kdp1965/tt07-um-lisa-ttlc/lisa-test/README.md

# LISA Commander — browser-based programmer, console and debugger

A Web Serial app for testing the **LISA** microcontroller (`tt_um_lisa`, TT06 and
TT07) on a Tiny Tapeout demo board, in the spirit of the
[TinyQV programmer](https://program.tinyqv.com/): connect the board, click
**Program**, and talk to the running program through a UART console.

Live: **https://kdp1965.github.io/tt07-um-lisa-ttlc/** (Chrome or Edge).

Everything lives in this directory:

| | |
|---|---|
| `web/index.html` | the app — a single page, no build step, no external scripts |
| `web/assets.js` | generated: the board-side Python and the demo firmware, embedded |
| `web/build_assets.py` | regenerates `assets.js` after editing `board/` or `firmware/` |
| `board/uartPass.py` | USB ↔ LISA-debug-UART pass-through, installed on the board's filesystem |
| `board/lisa_flash.py` | project select/reset and direct SPI-flash programming; sent to the board's RAM on connect |
| `board/ttlc_sim.py` | PIO + DMA emulation of the TTLC's 74HC595/74HC166 I/O chains; sent to RAM on connect |
| `firmware/bringup_tt07`, `bringup_tt06` | the bring-up demo (prints a banner on `?`), one hex opcode per line |
| `firmware/sdcc_hello.ihx`, `firmware/sdcc_hello/` | the same demo in C, built with the SDCC LISA port (`sdcc -mlisa`, in `lisa-tools/sdcc-lisa`); `s` prints the count and sum with a working `%u` |
| `firmware/lisa_monitor_small.ihx`, `firmware/lisa_monitor.ihx` | the LISA monitor (`lisa-tools/lisa_monitor`, `make commander` copies both here): `help`, RAM dump and write, the stack, `free` with the stack's high-water mark, `calc` with bf16 on the FPU, timed. The small one runs in the chip's 128-byte RAM and needs nothing on the board; the other is built with `--tt07-cache` and sets float32 (the software library) beside the bf16 - the app sets the data cache up on the RP2040's SPI RAM (the "Data cache" box, ticked for it) before the run, offering to flash the RP2040's MicroPython first if it lacks the emulation (`firmware/rp2040/`) |
| `firmware/ttlc/` | TTLC programs with their `.hex` from `mc14500_as.py`: `ttlc_loopback.asm` (inputs → outputs) and `elevator6x2.asm` (6 floors, 2 cars; generated by `gen_elevator6x2.py`, I/O map in `elevator6x2.h`) |
| `firmware/ttlc_tick/` | a LISA assembly program that could clock the TTLC from timer 1 through PORT E (TTLC addresses 128–135); not built or tested yet |
| `firmware/rp2040/` | Ken's MicroPython build for the RP2040 with the SPI RAM emulation (`rp2.enable_sim_spi_ram`, from the `lisa_spi_ram` branch of his micropython fork; provenance and rebuild notes in its README), embedded too. When an image for the data cache is chosen on a board whose MicroPython lacks the emulation, the app asks first, then restarts the RP2040 into its bootloader, has you choose the `RPI-RP2` drive, writes the `.uf2` there and reconnects once the board is back (the TT SDK and the files on its flash survive). Writing to the drive needs Chrome/Edge's directory picker: a page cannot write to a disk on its own, so the drive is chosen the first time, then remembered (one click to allow it again, none once the browser persists the permission); otherwise download the file and copy it by hand. Before it flashes anything the app backs the RP2040 up: the whole flash (MicroPython and its files, read through the XIP window) as a `.uf2` like the stock image, downloaded and kept in the browser (IndexedDB, per board); the Board panel's "Back up RP2040" does that on its own and "Restore…" flashes that backup or any `.uf2` |
| `test/` | hardware regression test of the app's protocol code (Node + a small serial bridge) |

## Using it

You need Chrome or Edge, a TT06/TT07 demo board running the TT MicroPython SDK
(2.0.x), and the QSPI Pmod on the bidirectional Pmod connector — LISA runs from
the SPI flash on `uio[0..3]` (CS, MOSI, MISO, SCK). The PSRAMs and the Pmod's
`SD2/SD3` lines are not used.

Open the page (GitHub Pages, `python3 -m http.server` in `web/`, or simply
double-click `index.html` — Chrome treats local files as a secure context), close
any `mpremote`/terminal session on the port, then:

1. **Connect board** and pick the board's serial port. The app enters the raw
   REPL, checks the SDK and shuttle, installs or updates `/uartPass.py` on the
   board if needed, probes the flash (JEDEC ID), enables `tt_um_lisa`, pulses its
   reset, starts the pass-through, locks the debug UART's autobaud, checks the
   debugger version (`lisav1.2`) and writes the setup registers. About 3 s.
2. **Program** the selected image. Two methods, chosen with the radio buttons:
   * **Direct** — the RP2040 drives the flash's SPI pins itself (SoftSPI, ~2 Mbit/s),
     while LISA is deselected so the ASIC is not driving those pins. The flash is first
     forced back into plain SPI mode (TinyQV leaves it in QSPI continuous-read mode),
     then sectors are erased, pages programmed and read back. Afterwards LISA is
     re-selected, reset and set up again. A few hundred ms for the demo, plus ~2 s
     for the re-initialization.
   * **Via LISA** — the debug UART: halt, `w21 0006`/`w21 01d8` (write-enable, 64 KB
     block erase), then one `w20xxxx` write and `r22` status poll per opcode. The
     flash sees exactly what LISA's own QSPI controller sends. Measured at
     3.8 ms per opcode in a browser-equivalent setup: ~3 s for the 799-opcode demo,
     a couple of minutes for a full 32K-opcode image.
3. With **Run after programming** ticked, the core starts at PC 0 and gets the UART
   (`l`). Click into the console and press `?` for the banner (`s` prints a
   counter line, unformatted: the firmware's `printf` does not do `%d` yet).

The **LISA core** panel has Run / Halt / Resume / Step / Reset, the registers
(PC, SP, RA, IX, ACC, flags, cond, and the opcode at PC read from the flash) and
a dump of the 128-byte data RAM with SP marked. **Verify** reads the flash back
(over SPI or through LISA, per the selected method) and compares it with the
image. Step and the RAM dump work around two properties of the TT07 silicon,
see below.

### TTLC (the MC14500B logic controller)

The TTLC runs its own program from the flash (16-bit words at `{reg 0x1f, 8'h0} |
pc << 1`; `inst[3:0]` opcode, `inst[15:4]` address — what `mc14500_as.py`
emits) and talks to the outside world through 48 outputs and 48 inputs on three
74HC595 / 74HC166 chains: three data lines each way, a shift clock and a latch,
all on `uo_out` / `ui_in` once debug register 0x1b routes them there
(`uo_out[0..2]` data out, `[5]` latch, `[6]` shift clock, `[3]` ttlc_reset;
`ui_in[6:4]` data in). On the demo board those are RP2040 pins, so
`ttlc_sim.py` plays the chains with two PIO state machines and two DMA ring
buffers: the outputs are always available in RAM, the inputs are replayed on
every scan, and the CPU is never involved. It is driven in-band through the
pass-through (`uartPass.py` 2.1's NUL-framed sideband), so the LISA console
keeps working meanwhile.

The panel programs a TTLC image at its own flash base (default 0x010000, 64 KB
aligned, with either programming method), sets registers 0x1f / 0x1b / 0x1c
(shift-clock divider; `clk/32` by default), invalidates the TTLC instruction
cache, and leaves the TTLC halted at PC 0 (the chip is reset: the TTLC PC is
not writable). **Run / Halt / Restart**, **Step**, **Scan** (run until the next
`nopo`, i.e. one PLC cycle — the reliable stepping unit, see below), a code
window with a MC14500B disassembly, 48 output LEDs refreshed live and 48 input
toggles. I/O addresses: 0–47 outputs, 48–95 inputs, 96–127 storage (96–103 are
also the port to LISA, 104 the LISA interrupt), 128–135 from LISA, 136 = RR.

**Timing.** The TTLC has no timer and only 32 storage bits, so a PLC program
takes its clock from the I/O rack: the emulator toggles **input 47** every N ms
(the field next to the input grid, default 500 ms, 0 = off) and programs
edge-detect it.

**The elevator controller** (`elevator6x2.asm`, 531 instructions) runs two
collective-control cars over six floors. Inputs are momentary buttons, the same-
numbered outputs are sticky request indicators: inputs 0–9 are the hall calls
(F0 up, F1 up/down, F2 up/down, F3 up/down, F4 up/down, F5 down), 10–15 car 1's
cabin buttons for floors 0–5, 16–21 car 2's. Outputs 32–37 / 38–43 show where
each car is, 22/23 its door, 24–27 its direction. On every tick a car keeps its
door open (two ticks), closes it, opens it because a request is at its floor
(clearing that floor's indicators), or moves one floor toward the nearest
pending request, continuing in its direction while something is ahead. A new
hall call is dispatched to one car: the car already at that floor, else an idle
car (the one within two floors when both are idle), else car 1; a car stopping
at a floor clears every call there. When this program is selected, a picture of the
building appears in the right column (floors numbered 1–6 there): six floors, both shafts with the cars
gliding between floors (doors open on dwell, direction lamps), hall-call
buttons per floor and a cabin panel per car — all momentary buttons, lit from
the TTLC's indicator outputs. Press a hall call, watch both cars go; the first
one to arrive clears it. `gen_elevator6x2.py` emits the
`.asm` (the two cars run identical logic on different addresses, and the
MC14500B has no indirect addressing); `mc14500_as.py` now accepts the
hardware's 12-bit addresses and comments inside `enum` blocks. **Show source**
in the TTLC panel opens the selected program's assembly and headers.

### The UART console

The console is the pass-through to LISA's debug UART, so it is either talking to
the **debugger** (type `v`, `r02⏎`, `w020000⏎` … yourself) or, after `l`, to the
**LISA program**. The pill above the console shows who owns it. Run/Resume hand
the UART to the program; Halt and the other debugger actions take it back with
`+++` (300 ms guard either side) and hand it back afterwards when the program is
still running. Enter sends CR; Ctrl-C is never sent (it would stop the
pass-through on the RP2040); the bring-up firmware drops characters that arrive
back to back, so paste sparingly.

### TT07 silicon notes (what the app does about them)

Found by reading `lisa_dbg.v` / `lisa_core.v` / `tt_um_lisa.v` and confirmed on a
TT07 board:

* **Debugger data reads return `RAM[IX]`.** With the data cache off, the cache's
  `d_ready` is a constant 1, so the core answers a register-6 read (`dbg_ready =
  d_ready_r`) in the access's first clock — before the pipelined address register
  and the RAM have seen the debugger's address. What the debug controller latches
  is the RAM output for the *idle* address, which while halted is IX
  (`d_addr = stop ? ix : …`). The app therefore reads RAM by saving IX, writing
  the wanted address to IX (register 5), reading register 6, and restoring IX.
  Writes through registers 7/6 land correctly. (The same RTL with the cache
  *enabled* produces a proper multi-cycle ready, which is presumably why this
  looked fine on TT06 with an SRAM.)
* **The step bit does nothing.** Register 0 bit 2 pulses the core's `stop` low for
  a single clock (`cont` is cleared by `cont_q` on the next edge), and the TT07
  pipeline's pre-decode state checks `stop` again and returns to fetch, so no
  instruction executes and PC does not move. The app's Step instead decodes the
  opcode at PC, puts hardware breakpoints (registers 0x08–0x0d) on every address
  it can continue at — fall-through, branch target, RA for `ret`/`rc`/`rz`/`reti`,
  IX for `call ix`/`jmp ix` — resumes, waits for the halt, and clears them. `rets`
  (returns to IA, not readable) only gets the fall-through breakpoint.
* **A halt right after a store loses the store and overwrites RAM[IX].** A
  store's RAM write completes in the fetch cycle after its instruction; a
  hardware breakpoint on the next instruction raises `stop` in that very cycle,
  and while stopped the data address is IX and the data the debugger's last
  written byte (`lisa_core.v`: `d_addr = stop ? ix`, `d_o = dbg_di`). Measured:
  stopped right after `push a`, the slot kept a marker and RAM[IX] got 0x02, the
  data byte of the resume command. So the app never halts there: Step runs a
  store (`sta`/`stax`, `dcx`/`inx`, `swap`, `stxx`, `shl16`/`shr16`, `push`,
  `sra`, `div`/`rem`) on to the first instruction that is safe to halt at, and
  **Halt** samples PC while the program runs (register 2 reads live), plants
  breakpoints on the safe addresses of the loop it is in and lets it run into
  one — only if none is hit within a second does it fall back to the plain halt,
  with a warning. Programming and Run (restart from 0) still halt immediately.
  `test/hw_test.mjs hazard=<test_core.ihx>` checks it on the chip.
* **Reading register 0xf advances PC.** Any access to the "current opcode"
  register increments PC afterwards (`dbg_inc`: it is meant for loading code),
  which looks like "stepping" if you poll it. The app never touches 0xf; the
  opcode shown is read from the flash at `2 × PC`.
* **The TTLC input scan shifts 17 times** (`shift_reg_io.v`, state
  `SHIFT_IO`). The input shift is keyed on `!shift_clk && clk_count == 0` (the
  clock is low and about to toggle), which is right for the 16 real rising
  edges — but after the 16th falling edge the FSM waits one more clock period
  before going to `LATCH`, and in that period the toggle is suppressed by
  `last_clk` (`if (shift_clk | ~last_clk)`) while the shift condition is still
  true. The `shift_count` decrement next to it is gated with `!last_clk`; the
  input shift is not. The 16-bit register keeps the last 16 of the 17 samples:
  the chain's bit 15 is shifted out, bits 14…0 land in bits 15…1, and bit 0
  gets sample 17 — whatever the data line holds after the last clock: with a
  74HC165 chain that is the level shifted in behind bit 0 (its DS pin), so per
  16-bit segment `input_pins[i] = external bit i-1` for i = 1…15 and input 0
  reads a constant: every input one position too high, bits 15/31/47 lost.
  (The loopback showed it as `0001 → 0003`, `aaaa → 5554`, with the emulator
  holding bit 0 on the line.) RTL fix, e.g. for an FPGA build: add
  `&& !last_clk` to the input shift condition. Hardware fix for the TT07
  silicon: delay each data-in line by one shift clock — a D flip-flop (one
  74HC175 for the three lines) clocked by the shift clock between the 165
  chain and `ui_in[6:4]`, or simply wire the parallel inputs one stage closer
  to the serial output so a dummy bit is clocked out first. (The planned
  respin of the TTLC Pmod — the first one has its input and output connectors
  swapped — adds that 74HC175 as a 17th dummy stage on each of the three
  chains.) The emulator does
  the same in software (each bit presented one edge later); untick "play the
  TT07 silicon's 17-sample input scan" in the panel (before starting the TTLC)
  for RTL that has the fix.
* **The latch pulse cannot load a 74HC166.** `latch` is pulsed low before the
  scan with the shift clock held still; a 74HC166 loads its parallel inputs
  only on a clock edge while /PE is low, so on a real I/O Pmod use a 74HC165
  (asynchronous /PL) for the inputs. The output side (74HC595: data on rising
  edges, RCLK pulse after the 16 clocks) matches the RTL as is.
* **The TTLC step bit cannot work** (`ttlc_halt = !run | step` blocks the fetch
  whose `ttlc_i_ready` would clear `step`), and **its breakpoints stop one
  instruction late** when the next instruction is already in the single 4-word
  instruction cache: the compare runs a clock behind the fetch, and the
  instruction executed in that clock loses its PC effect if it is a
  `jmp`/`rtn`/`nopf`. Step therefore reports where the TTLC really stopped;
  Scan is exact because a `nopo` stalls the core until its I/O scan is done.
* **Interrupts cannot be used with compiled code.** The core samples an
  interrupt in the cycle that executes an `if`/`ifte`/`iftt` or the first
  word of an `ldx`, saving neither the predicate nor the pending literal:
  after `rets` the predicated instruction runs unconditionally, and the
  `ldx` gets the vector word with its literal executed as an opcode later.
  `lisa-tools/sdcc_test/test_irqhaz.ihx` counts both on the chip (2 and 1
  in 20 ms with a 1 ms timer). Handlers work, but only around hand-written
  code that avoids `if*` and `ldx` (`test_irq2.ihx`). Details and the RTL
  fixes in `lisa_isa.md` ("TT07 interrupt notes").
* **The ALU's carry/borrow flags are wrong in the corner cases** (found while
  running the SDCC test suite on the chip; `lisa_core.v` lines 643–652). The
  adder is `acc + acc_adder` with `acc_adder` an *8-bit* operand, and the
  carry-in is folded into that operand instead of being a real carry-in, so it
  is lost when the operand wraps:
  * `add M` adds without C — that one is by design (`adc` is the carry form);
    the ISA doc used to say `+C` and has been corrected;
  * `adc #k` adds `(k + C) & 0xff`: `adc #0xff` with C = 1 adds 0 and clears C;
  * `sub M` adds `~((M + C) & 0xff) + 1` (8 bits): `sub M` with M = 0, C = 0
    computes A + 0 and reports a borrow (C = 1), and `cmp M` with M = 0 reports
    a borrow for the same reason — `A - 0` always "borrows";
  * `cpi #k` sets C from a plain unsigned `k > A` comparator (correct) but never
    records the sign inversion, so `if slt`/`sgt` after `cpi` behave unsigned;
    the inversion (A[7] ^ M[7]) is captured only by `add`/`adc`/`sub`/`cmp` and
    cleared by every other flag writer (`ldi`, `ldc`, `shl`, `shr`, `inx`…).

  Results in A are always correct; only C (and the signed compare) can be wrong.
  `lisa-tools/lisa_sim` models the silicon exactly (the SDCC test suites pass
  identically on it and on the chip), and `sdcc -mlisa` works around it: multi-byte
  adds use `adc #0` for the carry-in before `add M`, subtractions are done as
  `adc #~k` with a `ldc 1` start and an `if nc` guard, and compares against
  memory first test the operand against 1 (`cpi #1`) so a zero operand takes
  the `ldc 0` path instead of `cmp`.

### Flash base (Advanced)

Default 0. A 64 KB-aligned base lets a LISA image coexist with other flash
contents (TinyQV firmware at 0, say). It is written to debug registers 0x10–0x12
and used by both programming methods and by Verify.

### Setup registers

Written on every (re-)initialization and read back (these were spread over
`loadFlash()`/`setFlashBase()`/`noCache()` in `lisa_pydb.py`, but a program loaded
directly needs them too):

| reg | value | |
|---|---|---|
| 0x11 / 0x12 / 0x10 | flash base | debug QSPI address MSB, LISA1 base, debug address LSB |
| 0x1c | 0x0000 | uio mux: plain SPI pins |
| 0x1b | 0x5455 | uo_out mux: LISA PortB |
| 0x17 | 0x0004 | CE0 is a single-SPI flash with 24-bit addresses |
| 0x1e | 0x08d3 | SPI mode 1, SCLK divider 3, 13 clocks between CE activations |
| 0x1d | 0x0007 | data cache off: the 128-byte RAM is the whole data space (no SRAM needed) |

### Firmware formats

* Intel HEX (what `sdcc -mlisa` writes; record addresses are byte addresses, 2 × PC),
* one 4-digit hex opcode per line (what `lisa_ld` and `lisa_pydb.py` use),
* `@addr` plus 2-digit hex bytes (the cocotb `firmware.hex` format; `@addr` is a byte address),
* a raw `.bin`.

Opcodes are stored little-endian at byte address `2 × PC`, which is what the
debugger's `w20` writes and what LISA's instruction fetch reads.

## Board side

`uartPass.py` is what makes the USB serial port behave as LISA's UART. It is
installed to `/uartPass.py` if missing or different from the copy in `board/`,
and is also what `lisa_pydb.py --init` imports. Note that it uses **UART0** on
GPIO12/13 (`ui_in[3]`/`uo_out[4]`): on the RP2040 those pins are UART0, and
`machine.UART(1, …)` on them raises `ValueError: bad TX pin`. It re-creates the
UART each time it starts (the SDK changes the RP2040 clocks when a project is
enabled), and passes bytes through unmodified in both directions.

`lisa_flash.py` is never stored on the board: the app sends it, stripped of
comments and docstrings, over the raw REPL (raw-paste mode) on every connect.
With the TT SDK loaded the RP2040 has only ~65 KB of fragmented heap, which is
why the transfers use 512-byte chunks and why the app soft-reboots the board
(through the friendly REPL, so `main.py` runs) if the SDK's `tt` object is gone
or a `MemoryError` shows up.

After editing `board/*` or `firmware/*`:

```sh
python3 web/build_assets.py
```

## Manual use (mpremote / lisa_pydb.py)

```sh
mpremote cp board/uartPass.py :/uartPass.py
mpremote repl
>>> tt.shuttle.tt_um_lisa.enable()
>>> import uartPass          # now the REPL *is* LISA's debug UART; Ctrl-C ends it
v                            # -> lisav1.2
```

`lisa_pydb.py --init --flash --run bringup_tt07` (in the `lisa-tools` repo) does the
same thing from the command line.

## Hardware test

`test/hw_test.mjs` runs the app's real protocol code (the `lisa-core` script block)
under Node against a board, through `test/bridge.py` (pyserial, TCP 5555):

```sh
python3 test/bridge.py /dev/cu.usbmodemXXXX &
node test/hw_test.mjs            # connect, direct, vialisa, verify, debug, disconnect
```

It programs an altered demo directly (banner ends in `LISA*`), the original via
LISA (`LISA!`), verifies both ways, and exercises halt, a dozen single steps
checked against the image's decode, RAM read-back, reset/resume, the `+++`
hand-back and reconnecting; the `ttlc` scenario programs the loopback at
0x10000 and the elevator example (via LISA) at 0x20000, checks the 48-bit
loopback for several patterns, Step, Scan, that LISA's console still works
while the TTLC scans, and the elevator controller (via LISA at 0x20000); the
`elevator` scenario rides it with a fast tick. It overwrites the first three
64 KB blocks of the flash.

`ihx=<file>` programs an `sdcc -mlisa` program directly and waits for its
`ALL PASSED` / `SOME FAILED` (the `lisa-tools/sdcc_test` suites); `spiram=`
and `monitor=` do the same with the data cache on the RP2040's emulated SPI
RAM. `clock=<MHz>[/<RP2040 MHz>]` before `connect` runs the project at that
clock instead of the SDK's 50 MHz: `lisa_select` raises the RP2040 to twice
the project clock (its PWM reaches half its system clock; an even divider
gives a clean 50 % clock) unless told which, re-creates its UART and resets
LISA so the autobaud measures anew. The TT07 LISA passes every suite at
66 MHz and its debugger no longer answers from 67 MHz up (2026-10-08); its
TIMER1 counts core clocks, so a benchmark's ticks come out the same at any
clock - the chip scales with it.

## Publishing

`.github/workflows/pages.yaml` deploys `lisa-test/web` as this repository's
GitHub Pages site, **https://kdp1965.github.io/tt07-um-lisa-ttlc/**, on every
push to `main` that touches `lisa-test/` (or by hand from the Actions tab). It
regenerates `assets.js` first and warns if the committed copy was stale.

A Pages deployment replaces the whole site, so the GDS viewer job in `gds.yaml`
now only runs when that workflow is started manually — doing so would put the
viewer back in place of the app until the next `pages` run.

## Troubleshooting

* **"could not enter the MicroPython raw REPL"** — something else holds the port
  (mpremote, a terminal), or the board is wedged: press its reset button.
* **"LISA's debug UART does not answer"** — the autobaud needs `ui_in[7]` low at
  reset and the debug RX on `ui_in[3]`; the app sets both. Try *Re-init LISA*.
* **"no SPI flash answers on uio[0..3]"** — the QSPI Pmod is missing or on the
  wrong connector.
* **The board stops responding to USB** — MicroPython hit a fatal error (an
  uncaught `MemoryError` in the raw REPL does this). Reset the board.
