kdp1965/tt07-um-lisa-ttlc/(commit log)

2024-05-24 Changed to TT06 gds github flow.
2024-05-25 Reverted to tt06-openlane2 flow.
2024-05-25 Updated header for rename_yosys_cells.py and fixed tt07 gds flow.
2026-10-06 Add LISA Commander: Web Serial programmer, console and debugger
    lisa-test/ holds a single-page Web Serial app for the TT06/TT07 demo board
    with the QSPI Pmod: it installs uartPass.py on the board, selects and resets
    tt_um_lisa, locks the debug UART autobaud, sets up the debugger registers,
    programs the SPI flash either directly from the RP2040 (SoftSPI) or through
    LISA's own debug/QSPI logic, verifies, runs/halts/steps the core, shows the
    registers and data RAM, and provides a pass-through console to LISA's UART.
    The app works around three properties of the TT07 silicon, confirmed on a
    board: debugger data reads return RAM[IX] (so RAM is read through IX), the
    single-step bit does not execut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
    [bridge.py, lisa_flash.py, uartPass.py]
2026-10-06 LISA Commander: disassembly of the code around PC while halted
    Port DisassembleOpcode() from lisa_ide (src/Lisa.cxx) to the page and show
    eight opcodes around PC, read from the flash, under the registers whenever
    the core is halted (PC marked). Branch targets are shown as absolute
    addresses and ldx's operand word is shown as data.
    Step now treats ldx as the two-word instruction it is (breakpoint at PC+2),
    so it no longer halts on the operand word. The hardware test steps from
    reset across the crt0 ldx and checks the decoded code window.
    Also drops the console hint about the demo's "s" command, whose printf
    output is not formatted yet.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
2026-10-06 LISA Commander: TTLC (MC14500B) programming, run control and emulated I/O
    The TTLC runs its program from its own flash base and talks to 48 outputs /
    48 inputs through 74HC595 / 74HC166 chains on uo_out / ui_in. Those are
    RP2040 pins on the demo board, so board/ttlc_sim.py plays the chains with two
    PIO state machines and DMA ring buffers (no Pmod needed), driven in-band
    through a NUL-framed sideband added to uartPass.py (2.1) so the LISA console
    keeps working. The new panel programs a TTLC image (either method), runs,
    halts, steps, scans (to the next nopo), shows a MC14500B disassembly around
    PC, 48 live output LEDs and 48 input toggles. Includes a loopback test
    program and the elevator exam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
2026-10-06 LISA Commander: 6-floor / 2-car elevator controller for the TTLC, tick source
    elevator6x2.asm (generated by gen_elevator6x2.py, I/O map in elevator6x2.h):
    two collective-control cars, momentary buttons latched into sticky request
    indicators, hall calls answered by both cars, cabin calls per car, one floor
    per tick with a two-tick door dwell. The timing comes from the emulator: it
    can toggle input 47 at a configurable period (the TTLC has no timer and only
    32 storage bits), set from the TTLC panel.
    Verified on a TT07 board (test scenario "elevator"): both cars start at
    floor 0, a hall call to floor 3 is latched and served by the first car to
    arrive, cabin calls bring each car to its floor, a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
2026-10-06 LISA Commander: graphical elevator view for elevator6x2 (momentary buttons, live cars/doors/lamps)
    Shown in the right column when the 6-floor / 2-car program is the selected
    TTLC program: an SVG of the building with hall-call buttons per floor and a
    cabin panel per car (pressed while held, minimum 120 ms pulse), the cars
    moving between floors, doors opening on dwell and direction lamps, all
    driven from the TTLC's outputs by the live poll (now 5 Hz).
2026-10-06 LISA Commander: elevator dispatch, Show source, layout; drop the old snippet
    elevator6x2: a new hall call is now dispatched to one car (the car at that
    floor, else an idle car - the one within two floors when both are idle -
    else car 1), per floor, in six of the spare storage bits; cars only count
    the hall calls assigned to them, and a car stopping at a floor still clears
    every call there. Verified on the board: one car answers, the other stays.
    The elevator picture moves below the Log, beside the TTLC panel. "Show
    source" in the TTLC panel opens the selected program's MC14500B assembly and
    its headers (embedded in assets.js). The pre-tapeout elevator_ctrl snippet
    is removed; the hardware t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
2026-10-06 LISA Commander: 16-sample scan option for fixed RTL; silicon-note details
    The I/O emulator can play either the TT07 silicon's 17-sample input scan
    (default) or a plain 16-sample 74HC165 timing for RTL that has the fix (an
    FPGA build, or a respun Pmod with a 74HC175 dummy stage): a checkbox in the
    TTLC panel, applied when the TTLC is next started. On the TT07 board the
    16-sample mode shows the expected one-position shift and the default mode is
    exact (hardware test "tick", which also checks the tick on input 47).
    README: the 17-shift bug explained with the two RTL conditions, the input
    mapping and symptoms, the RTL fix, the hardware fix (74HC175 or shifted
    parallel wiring; planned for the Pm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
    [ttlc_sim.py]
2026-10-06 LISA Commander: load Intel HEX, add the sdcc_hello C demo, document the ALU carry bugs
    parseFirmware now accepts Intel HEX (what sdcc -mlisa writes): record
    types 0/1/2/4, length and checksum checks, byte addresses = 2 x PC.
    firmware/sdcc_hello is the bring-up demo rewritten in C and built with the
    SDCC LISA port; its .ihx is embedded in the app and its Makefile depends on
    the library .rel files so a compiler/library change rebuilds it.
    hw_test.mjs gains two scenarios: `sdcc` (programs the demo, checks the
    banner, the owl and a printf("%u") of the count and sum on the chip) and
    `ihx=<file>` (programs any Intel HEX and waits for ALL PASSED/SOME FAILED,
    used to run the sdcc_test suites on sil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
    [sdcc_hello.c]
2026-10-06 lisa-test README: interrupts cannot be used with compiled code on TT07 (predicate and ldx literal lost)
2026-10-07 lisa-test: the data cache on the RP2040's emulated SPI RAM (hw_test.mjs spiram=, lisa_spiram.py)
    hw_test.mjs "spiram=<file>[@MHz]" programs a test, enables the simulated
    SPI RAM on the board (the mbell_micropython lisa_spi_ram build), puts
    CE1 on uio[4], CS1 in plain SPI with 16-bit addresses in SPI mode 1,
    checks a pattern through the debugger's QSPI port, points the data
    cache at CS1 and runs the program; on a hang it reports the RAM's
    command counters. lisa_spiram.py does the same from the board's REPL
    (setup / pattern / cache). Every sdcc_test suite passes this way on
    the TT07 chip with the compiler's workarounds for swap n(sp) and the
    read-modify-write-on-a-miss fault (lisa_isa.md).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
    [lisa_spiram.py]
2026-10-07 lisa-test: spiram= / monitor= take register overrides; SCLK clk/4 for the SPI RAM
    spiram=<file>[@MHz][,<reg>=<value>...] overrides 0x1c/0x17/0x1e/0x16
    before the pattern test. The default 0x1e is now 0x1ff1 (mode 1, CE
    delay 127, clk/4 = 12.5 MHz at 50 MHz): every suite passes through the
    cache at that rate, clk/2 fails the RP2040 emulator's pattern test and
    a CE delay of 64 or less garbles its commands. The flash shares the
    divider, so instruction fetches (plain SPI, 96 clocks per 4-word line)
    are twice as fast too. lisa_spiram.setup() defaults to clkdiv=1.
    [lisa_spiram.py]
2026-10-08 lisa-test: a project clock other than the SDK's - lisa_select(clock, sysclk) raises the RP2040 to twice the project clock (or the one given) for its PWM, re-creates its UART and resets LISA for a fre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
    [lisa_flash.py]
2026-10-08 lisa-test: the LISA monitor as a firmware choice in the Commander - a "Data cache on the RP2040's SPI RAM" box (ticked for images built with --tt07-cache) and LisaCommander.spiRamCache(), which sets 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
2026-10-09 lisa-test: the 128-byte monitor (lisa_monitor_small.ihx, nothing special on the board) beside the cache build in the Commander's list; hw_test run=<file> programs an interactive image and leaves its 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
2026-10-09 lisa-test: both monitors rebuilt - calc's fine tick rounded up (a run past the tick's range wrapped the count and printed 0 us)
2026-10-09 lisa-test: the RP2040 MicroPython with the SPI RAM emulation is a Commander resource - firmware/rp2040/micropython-lisa_spi_ram.uf2 (Ken's lisa_spi_ram build, b26f01cda, README with provenance and th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
    Co-Author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
2026-10-09 lisa-test: back up the RP2040 before flashing it, and restore - the whole flash (MicroPython and its files; the size found by where the XIP window repeats) read back 2 KB at a time through uctypes.by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
2026-10-09 lisa-test: the RP2040 read-back as the board can do it - the flash sized by comparing XIP views (a 4 KB bytes() copy was a MemoryError on the TT SDK's fragmented heap, and the next connection wedged 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
2026-10-09 lisa-test: the RPI-RP2 drive is remembered - the directory handle kept in IndexedDB after a write; next time the dialog writes on its own if the browser kept the permission (polling for the drive to 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
2026-10-09 lisa-test: halt and step without the TT07 breakpoint hazard - a halt right after a store drops the store and writes the debugger's last data byte to RAM[IX] (lisa_core.v: the delayed write meets stop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
